EthanN1e/X1aoChuang-NYH/original-project/README.md

# 原开源资料归档

[完整原始资料归档](full-original.zip) 含原始工程以及 Objects 和 Listings 构建产物。为方便浏览，目录中单独列出源码、模型及其余资料。

本目录保存提供的原始云台资料：发射端与接收端 Keil 工程、STL 和 3MF、PCB Gerber、原物料清单，以及原资料中已有的构建文件。它们是上游项目资料，供复现与核对使用，不能视为本项目已经完成的改造。

项目立项范围以手控、中性载荷台架为准；原资料包含的其他机构与控制内容仅作为上游资料保留。原演示视频：https://www.bilibili.com/video/BV1of8y6vEQ5/ 。

未在所提供资料中发现完整的项目许可证。部分第三方代码声明其权利归原作者所有，且提到的 License.txt 未随资料提供。版权及授权归原作者；使用、修改或再次分发前，请核实上游和第三方组件的许可。不得将本仓库视为对这些文件的重新授权。
