EthanN1e/X1aoChuang-NYH/reference-display/README.md

# 显示项目参考资料

这里包含提供的 monitor 工程和电路图，供理解 ST7735 彩屏、编码器和按键连接方式。该工程原本运行在 ESP32-C3，手控云台使用 STM32 的显示移植仍待开发和测试。

公开版本中的 Wi-Fi 名称和密码已清空；如确需运行联网功能，请在本地配置，勿将凭据提交到仓库。屏幕供电、电平、接口和实物型号仍需核对。
