EthanN1e/X1aoChuang-NYH/hardware/r0/README.md

# R0 集成 PCB

| 文件 | 用途 |
| --- | --- |
| [gimbal-r0.epro2](gimbal-r0.epro2) | 嘉立创 EDA 专业版工程，包含三页原理图和 PCB1 |
| [assembly-bom.xlsx](assembly-bom.xlsx) | 两端焊接位号、型号、立创料号、数量及外接配件 |
| [pcb1-drc.json](pcb1-drc.json) | 保存并重载后得到的原生 DRC 记录，0 项违规 |

同版四层裸板 56 × 80 mm，一套用两块。手柄端装 63 件，包含 MPU-6050、1S 充电和 3.3 V 稳压。云台端装 36 件，接两只位置型舵机，由 J12 输入共地的稳压 3.3 V 和舵机电源。两端各接一个 nRF24L01+ 模块。R7、R26、J13 默认留空。

J6 预留带按压的 A/B 增量编码器，J5 接 ST7735 屏。屏幕与无线模块针序、外壳尺寸、舵机电流和供电余量待实物核对。R0 固件适配和两端联调仍待完成。

## 2026-11-05 板级复查与装配评审

本次在线 PCB DRC 未报告违规，但固定方向的 15 个手柄安装候选均与原壳网格相交，外壳适配尚未通过。请先看[复查结果与离线三维展示](review-20261105/README.md)。当前工程是审核修订版，尚未制造放行。

## 2026-11-06 电阻布局和走线优化

[新版嘉立创 EDA 专业版工程](resistor-layout-20261106/R0-resistor-layout.epro2)供本轮 PCB 审阅。[前后对照图](resistor-layout-20261106/resistor-layout-before-after.png)标出 J4 局部走线和全板改位的电阻。

检查全板 27 颗 0603 电阻，改位并重布线 11 颗。R5、R6 水平布置，RF_CE 和 RF_CSN 在 J4 下方改为平行直段配短 45° 转角。右侧 R7–R12 对齐。保存重开后严格 DRC 为 0 项违规，74 个器件引脚网络一致，54 个电阻焊盘的顶层阻焊开窗已核对。详见[核验记录](resistor-layout-20261106/verification.json)。样板焊接和制造审核待验证。
