EthanN1e/X1aoChuang-NYH/planning/DeepSeek任务/01_打印结构审查.md

# 任务 01 现有 STL 的结构审查与虚拟装配

请只使用用户提供的底座、Yaw 底座、Pitch 轴相关 STL，为无发射机构的双轴手控云台建立虚拟装配。原文件中其他结构件可能形成装配依赖，但不得把发射相关零件放入交付模型。若某个关键连接因缺件无法闭合，应明确报告缺件与所需的中性替代件。

工作：逐件列出文件名、包围盒尺寸、坐标方向、网格完整性、建议打印方向；在 CAD 中检查孔位与轴线相对位置、运动干涉、紧固件空间；给出需实测尺寸和需新画的中性载荷安装件清单。不得凭 STL 文件名推断物理尺寸精度。

交付：可编辑装配文件、零件清单 CSV、关键尺寸截图、干涉报告、打印试装建议。验收：他人可按文件名重新导入并复现检查；所有未知尺寸标记待测。
