EthanN1e/X1aoChuang-NYH/planning/DeepSeek任务/02_舵机载荷与活动空间.md

# 任务 02 MG996R 舵机载荷与活动空间模型

请针对不带发射机构的中性载荷台架，建立简单的静态载荷、重心和活动空间模型。输入为实测打印件质量、两只 MG996R 的所购批次参数、轴距和中性载荷质量。没有实测数据时全部参数化，不得代入未经来源确认的产品值。

工作：计算不同中性载荷质量及安装位置下的静态受力与重心偏移；基于 STL 虚拟装配检查双轴活动范围、线束余量和可能碰撞处；提供参数敏感性图。结论只用于试装优先级与测量计划，不保证实物承载性能。

交付：源脚本或电子表格、输入参数 CSV、图表、假设和实测计划。验收：改变载荷质量和轴距后自动重算；标出不确定性；不使用发射相关部件。
