EthanN1e/X1aoChuang-NYH/planning/DeepSeek任务/03_供电预算.md

# 任务 03 原项目供电预算

请根据用户提供的 Excel 原 BOM 和实际盘点结果，为两块 STM32、两只 nRF24L01、MPU6050、两只 MG996R、显示和按键建立供电预算。只覆盖无发射机构的手控云台。7.4 V、3.7 V 电池及 5 V 降压模块是原 BOM 物料，实际是否可用须待测，不得默认兼容。

工作：建立模块功率与峰值电流参数表；区分手册数据、实测和未知；比较电源、降压、导线与连接器的余量；列出需要万用表或示波器确认的指标。不得给出未验证的电池安全结论。

交付：电源树、可编辑预算表、不同工作场景汇总、待测清单。验收：所有输入有来源或“待测”标识；原 Excel 未填数量的线材不按已有处理。
