EthanN1e/X1aoChuang-NYH/hardware/r0/resistor-layout-20261106/resistor-layout-before-after.png

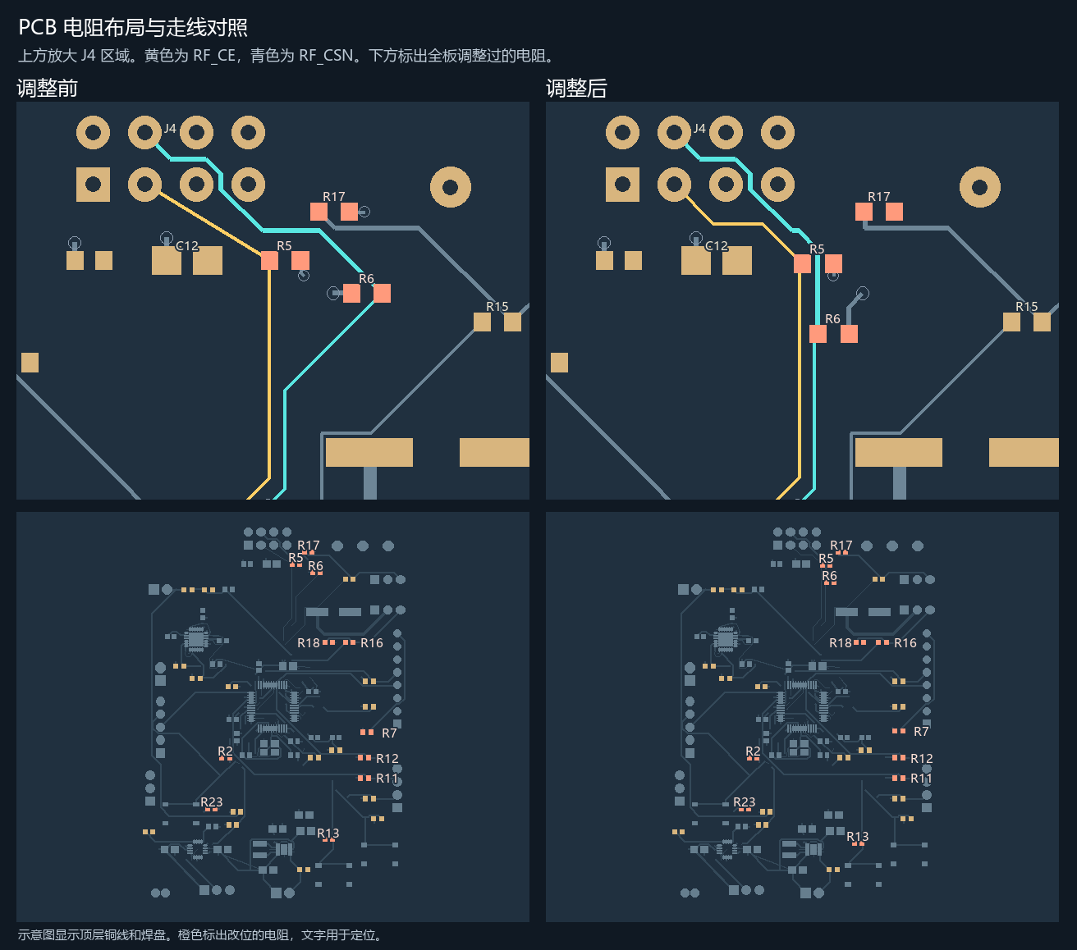
hardware/r0/resistor-layout-20261106/resistor-layout-before-after.png
