EthanN1e/X1aoChuang-NYH/planning/手柄彩屏界面草案.png

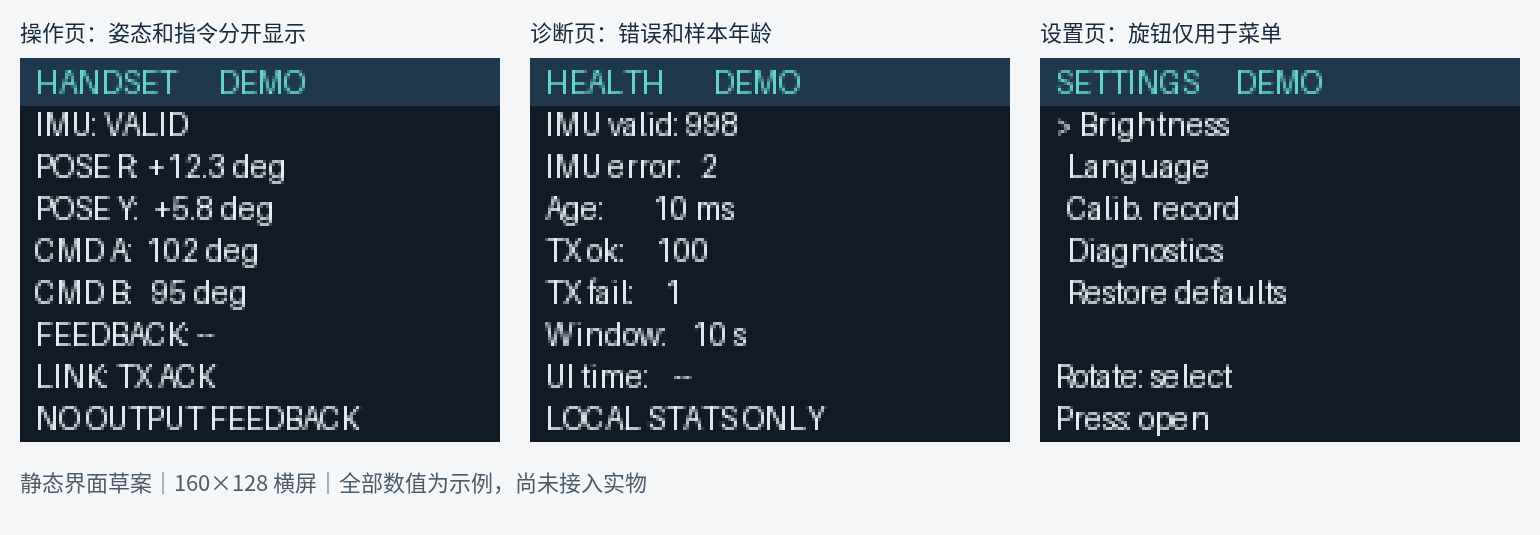
planning/手柄彩屏界面草案.png
