EthanN1e/X1aoChuang-NYH/reference-display/电路图.jpg

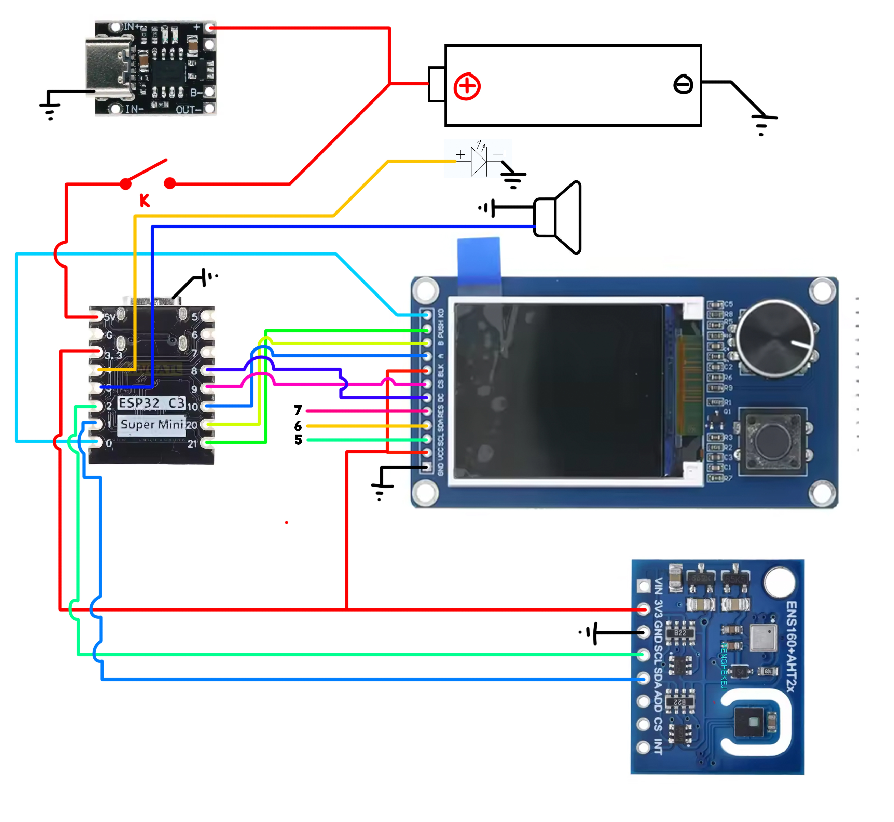
reference-display/电路图.jpg
