EthanN1e/X1aoChuang-NYH/planning/准备清单.csv

物料 | 所需数量说明 | 依据 | 库存状态 | 可用库存数量 | 规格核对及检索词 | 商品链接及SKU | 单价元 | 实际采购量 | 核对状态
STM32F103C8T6 | 2 | 原BOM | 待盘点 |  | 原 BOM；核对板型、晶振、稳压、下载接口及实际芯片标记。 |  |  |  | 待核对
nRF24L01 模块 | 2 | 原BOM | 待盘点 |  | 原 BOM；核对普通/带功放版本、供电、引脚及板间距离。 |  |  |  | 待核对
MPU6050 模块 | 1 | 原BOM | 待盘点 |  | 原 BOM；核对板型、电平、供电和手柄固定方向。 |  |  |  | 待核对
MG996R 舵机 | 2 | 原BOM | 待盘点 |  | 原 BOM；核对来源、工作电压、舵盘、连接与实际电流。 |  |  |  | 待核对
7.4 V 与 3.7 V 电池 | 各 1 | 原BOM | 待盘点 |  | 原 BOM；先核对化学体系、串数、保护和接口，再决定复用。 |  |  |  | 待核对
迷你 5 V DC-DC | 1 | 原BOM | 待盘点 |  | 原 BOM；核实输入范围与持续/瞬态供电能力，不能只看标称电流。 |  |  |  | 待核对
12×12 按键与 SS12D07G3 开关 | 各 2 | 原BOM | 待盘点 |  | 原 BOM；确认安装尺寸、接点和额定值。 |  |  |  | 待核对
排针及连接线 | 1 批 | 原BOM | 待盘点 |  | 原 BOM 无明确数量；按最终针脚表计数，区分信号线与电源线。 |  |  |  | 待核对
底座及双轴打印件 | 1 套 | 方案建议 | 待盘点 |  | 按 STL 装配关系清点；材料和填充率结合载荷试装确定。 |  |  |  | 待核对
紧固件与舵盘连接件 | 1 套 | 方案建议 | 待盘点 |  | 尺寸从模型与实物取值，记录螺钉长度及防松方式。 |  |  |  | 待核对
中性载荷安装件 | 1 套 | 方案建议 | 待盘点 |  | 适配双轴结构；记录质量、重心与独立测量基准。 |  |  |  | 待核对
电源保护及分配件 | 1 套 | 方案建议 | 待盘点 |  | 按实际电流确定保险、开关、接线端子与应力释放。 |  |  |  | 待核对
适配充电器 | 按电池体系 | 方案建议 | 待盘点 |  | 与电池串数、化学体系、保护方式匹配；原清单未明确。 |  |  |  | 待核对
下载与测量工具 | 复用或借用 | 方案建议 | 待盘点 |  | ST-Link、3.3 V 逻辑串口工具、万用表；按测试需要借用逻辑分析仪和可调电源。 |  |  |  | 待核对
ST7735 旋钮彩屏 | 1 | 方案建议 | 待盘点 |  | 优先复用同款；核对 128×160、SPI、编码器 A/B、按键、电平与孔距。检索：ST7735 彩屏 旋转编码器 模块。 |  |  |  | 待核对
屏幕支架和手柄上盖 | 1 套 | 方案建议 | 待盘点 |  | 按屏幕实测外形与孔位修改；检索：3D 打印 手柄 外壳 定制。 |  |  |  | 待核对
可靠插接件与柔性导线 | 1 套 | 方案建议 | 待盘点 |  | 按电流、间距、线径与接口选型；检索：带锁扣 连接器 线束。 |  |  |  | 待核对
独立返回键 | 0～1 | 方案建议 | 待盘点 |  | 同款模块若已提供则复用；检索：轻触 按键 模块。 |  |  |  | 待核对
角度夹具或独立测角工具 | 1 套 | 方案建议 | 待盘点 |  | 分辨率不是准确度，需核实校准与量程；检索：数显角度尺 固定夹具。 |  |  |  | 待核对
电池电压采样元件 | 条件项 | 方案建议 | 待盘点 |  | 确认电池最大电压和 ADC 允许范围后设计；显示百分比还需电池模型。 |  |  |  | 待核对
背光驱动或电平转换 | 条件项 | 方案建议 | 待盘点 |  | 只有核实模块电路后才能确定是否需要，不能统一默认添加。 |  |  |  | 待核对
