EthanN1e/X1aoChuang-NYH/hardware/r0/assembly-bom.xlsx

Sheet: 板载器件
R0 板载器件清单
一套 = 手柄端 PCB 1 块 + 云台端 PCB 1 块。以下为实际装配用量，0 表示默认留空。
数据来自 R0-DRC修复.epro2 的器件库和 PCB1 读回，覆盖全部 74 个 PCB 位号。请按两端焊接位号分料。
类别 | 已绑定器件型号 | 立创料号 | 封装／规格 | PCB 位号 | 手柄端 | 云台端 | 两板合计 | 手柄焊接位号 | 云台焊接位号 | 装配说明
主控 | STM32F103C8T6 | C8734 | LQFP-48，7 × 7 mm | U1 | 1 | 1 | 2 | U1 | U1 | 两端各一颗，分别烧录发射端和接收端固件。
姿态传感器 | MPU-6050 | C24112 | QFN-24，4 × 4 mm | U2 | 1 | 0 | 1 | U2 | — | 裸芯片上板，建议 SMT。25 号裸露焊盘按手册复核钢网开口。
充电与电源路径 | BQ24074RGTR | C54313 | VQFN-16，3 × 3 mm | U3 | 1 | 0 | 1 | U3 | — | 手柄端单节锂电池。建议 SMT。
3.3 V 升降压 | TPS63031DSKR | C15516 | VSON-10，2.5 × 2.5 mm | U4 | 1 | 0 | 1 | U4 | — | 手柄端逻辑供电。建议 SMT。
晶振 | X32258MOB4SI | C2682775 | 3225 四焊盘，8 MHz，CL 12 pF | Y1 | 1 | 1 | 2 | Y1 | Y1 | 与 C1、C2 配套。
功率电感 | VLS3015CX-1R5M-1 | C3223987 | 贴片，约 3 × 3 mm，1.5 µH | L1 | 1 | 0 | 1 | L1 | — | 手柄端 U4 升降压用。
电阻 | RC0603FR-0710KL | C98220 | 0603，10 kΩ，±1% | R1、R2、R3、R5、R6、R8、R9、R10、R11、R12、R13、R14、R17、R18、R25 | 13 | 7 | 20 | R1、R2、R3、R5、R6、R8、R9、R10、R11、R12、R13、R14、R25 | R1、R2、R3、R5、R6、R17、R18 | 两端位号不同，按各自列焊。
电阻 | RC0603JR-070RL | C95177 | 0603，0 Ω | R4 | 1 | 1 | 2 | R4 | R4 | 两端均装，模拟电源连接。
预留跳线 | RC0603JR-070RL | C95177 | 0603，0 Ω | R7、R26 | 0 | 0 | 0 | — | — | 默认留空。R7 待核对屏幕背光，R26 待验证关机漏电。
电阻 | RC0603FR-07100RL | C105588 | 0603，100 Ω，±1% | R15、R16 | 0 | 2 | 2 | — | R15、R16 | 云台端两路舵机 PWM 串联。
电阻 | RC0603FR-07100KL | C14675 | 0603，100 kΩ，±1% | R19、R27 | 2 | 1 | 3 | R19、R27 | R19 | R19 两端均装，R27 手柄端装。
电阻 | RC0603FR-0733KL | C126359 | 0603，33 kΩ，±1% | R20 | 1 | 1 | 2 | R20 | R20 | 电压采样分压。
电阻 | RC0603FR-074K7L | C99782 | 0603，4.7 kΩ，±1% | R21、R22 | 2 | 0 | 2 | R21、R22 | — | 手柄端 IMU 的 I²C 上拉。
电阻 | RC0603FR-073K24L | C273779 | 0603，3.24 kΩ，±1% | R23 | 1 | 0 | 1 | R23 | — | 充电电路设置电阻。
电阻 | RC0603FR-074K53L | C273802 | 0603，4.53 kΩ，±1% | R24 | 1 | 0 | 1 | R24 | — | 充电电流设置，按实际电芯允许充电电流核对。
陶瓷电容 | CL10C180JB8NNNC | C1647 | 0603，18 pF，50 V，C0G | C1、C2 | 2 | 2 | 4 | C1、C2 | C1、C2 | 晶振负载。
陶瓷电容 | CL10B104KB8NNNC | C1591 | 0603，100 nF，50 V，X7R | C3、C4、C5、C6、C8、C10、C11、C13、C14、C15 | 10 | 8 | 18 | C3、C4、C5、C6、C8、C10、C11、C13、C14、C15 | C3、C4、C5、C6、C8、C10、C11、C13 | C14、C15 仅手柄端装。
陶瓷电容 | CL21B104KBCNNNC | C1711 | 0805，100 nF，50 V，X7R | C22 | 1 | 0 | 1 | C22 | — | 手柄端稳压电路。与 0603 的 100 nF 分开领料。
陶瓷电容 | CL10A105KB8NNNC | C15849 | 0603，1 µF，50 V，X5R | C9、C18 | 2 | 1 | 3 | C9、C18 | C9 | C9 两端装。最终 PCB 的 C18 是 0603，仅手柄端装。
陶瓷电容 | CL21A106KAYNNNE | C2980800 | 0805，10 µF，25 V，X5R | C7、C12、C19、C20、C21、C23、C24 | 7 | 2 | 9 | C7、C12、C19、C20、C21、C23、C24 | C7、C12 | C7、C12 两端装。最终 PCB 的 C7 是 0805。
陶瓷电容 | CL10B222KB8NNNC | C16033 | 0603，2.2 nF，50 V，X7R | C16 | 1 | 0 | 1 | C16 | — | 手柄端 IMU 外围。
陶瓷电容 | CL10B103KB8NNNC | C1589 | 0603，10 nF，50 V，X7R | C17 | 1 | 0 | 1 | C17 | — | 手柄端 IMU 外围。
电解电容 | EEEFK1C471P | C79121 | SMD，470 µF，16 V，直径 8 mm | C25 | 0 | 1 | 1 | — | C25 | 云台端舵机供电缓冲，焊接时核对极性。
轻触开关 | TS-1187A-B-A-B | C318884 | 贴片，5.1 × 5.1 × 1.5 mm | SW1、SW2、SW3 | 3 | 1 | 4 | SW1、SW2、SW3 | SW1 | SW1 复位，两端装。SW2 归零、SW3 微调，仅手柄装。
SWD 排针 | PZ254V-11-05P | C492404 | 1×5，2.54 mm，直插公针 | J1 | 1 | 1 | 2 | J1 | J1 | VREF / SWDIO / SWCLK / NRST / GND。
串口／舵机排针 | PZ254V-11-03P | C2937625 | 1×3，2.54 mm，直插公针 | J2、J7、J8 | 1 | 3 | 4 | J2 | J2、J7、J8 | J2 两端装。J7 水平、J8 俯仰，仅云台端装。
BOOT0／开关排针 | PZ254V-11-02P | C492401 | 1×2，2.54 mm，直插公针 | J3、J11 | 2 | 1 | 3 | J3、J11 | J3 | J3 两端装，正常启动时跳线帽取下。J11 仅手柄端装。
采样预留排针 | PZ254V-11-02P | C492401 | 1×2，2.54 mm，直插公针 | J13 | 0 | 0 | 0 | — | — | 默认留空。云台端启用电压采样时增加 1 个，1 脚 GND、2 脚采样。
无线排母 | PM2.54-2x4PZZ-H8.5 | C54876740 | 2×4，2.54 mm，直插母座 | J4 | 1 | 1 | 2 | J4 | J4 | 两端各一座。nRF24L01+ 射频模块另列。
显示屏排针 | PZ254V-11-08P | C492407 | 1×8，2.54 mm，直插公针 | J5 | 1 | 0 | 1 | J5 | — | 手柄端。用线束按信号配线，核对 VCC 与 BL。
编码器排针 | PZ254V-11-04P | C2691448 | 1×4，2.54 mm，直插公针 | J6 | 1 | 0 | 1 | J6 | — | 手柄端。顺序为 GND、A、B、SW。
5 V 输入座 | B2B-PH-K-S | C20504437 | JST PH 1×2，2.00 mm，直插 | J9 | 1 | 0 | 1 | J9 | — | 手柄端。1 脚 5 V，2 脚 GND。
1S 电池座 | B3B-XH-AM(LF)(SN) | C161870 | JST XH 1×3，2.50 mm，直插 | J10 | 1 | 0 | 1 | J10 | — | 手柄端。1 脚 BAT+，2 脚 NTC，3 脚 GND。
云台稳压输入 | DG301-5.0-03P-12-00A(H) | C5128849 | 1×3，5.00 mm，螺钉端子 | J12 | 0 | 1 | 1 | — | J12 | 1 脚 GND，2 脚稳压 3.3 V，3 脚稳压舵机电源。
板载件合计 |  |  |  |  | 63 | 36 | 99

Sheet: 外接配件
外接模块、线束与调试件
按一套整机统计。共用／选配另计，屏幕、电池与外接稳压型号以备注中的实物条件为准。
依据 R0 的 J1–J13、原始物料清单及 monitor.ino。外接配件用量与板载插座分开统计。
分组 | 配件 | 型号／选型 | 规格 | 手柄端 | 云台端 | 共用／选配 | 接法与下单前核对
整机 | 同版裸 PCB | 手控云台 R0 DRC 修复版 | 56 × 80 mm，4 层 | 1 | 1 | 0 | 同一板图制作两块，按本表分别装配。
无线 | SPI 射频模块 | nRF24L01+ PCB 天线版 | 2×4，2.54 mm 公针，3.3 V | 1 | 1 | 0 | J4。板端顺序 GND / 3.3 V / CE / CSN / SCK / MOSI / MISO / NC。按模块实物核对方向。
显示 | SPI TFT 屏 | ST7735，128 × 160，8 针候选 | 3.3 V 逻辑，沿用 monitor 项目屏 | 1 | 0 | 0 | J5。PCB 顺序 GND / 3.3 V / SCK / MOSI / RST / DC / CS / BL。实物商品号和背光接法待核对。
操作 | 旋转编码器 | ALPS Alpine EC11E15244G1 | 增量 A/B，带按压，20 mm 扁轴候选 | 1 | 0 | 0 | J6。编码器公共端与按键地并接，合成 GND、A、B、SW 四线。轴长按外壳确认。
操作 | 编码器旋钮帽 | EC11 扁轴配套旋钮帽 | 按编码器轴截面和外壳选 | 1 | 0 | 0 | 与上行编码器匹配，外壳尺寸确认后定具体型号。
操作 | 面板电源开关 | 原清单 SS12D07G3 候选 | 保持型，两档，仅用公共端和一档 | 1 | 0 | 0 | J11 控制 REG_EN。用通断档确认触点脚位，J11 不承载舵机电流。
执行 | 位置型舵机 | TowerPro MG996R | 两轴各 1，只选位置型 | 0 | 2 | 0 | J7 / J8，GND / VSERVO / PWM。两只舵机的启动与负载峰值电流决定供电规格。
手柄供电 | 1S 电池 | 受保护单节 3.7 V 锂电池组 | 满充 4.2 V，配匹配的 10 kΩ NTC | 1 | 0 | 0 | J10。电芯型号与容量按仓位和允许充电电流定，线序按 BAT+ / NTC / GND。
手柄供电 | 充电适配器 | 5 V 稳压适配器 | 5 V / 1 A 或以上，配 J9 线束 | 1 | 0 | 0 | 手柄板载 BQ24074 负责 1S 充电。电源端接 PH 2P 线束，核对极性。
云台供电 | 2S 电池 | 7.4 V 受保护电池组 | 满充 8.4 V，容量与接头待定 | 0 | 1 | 0 | 按原物料表电压。选与充电器和负载匹配的电池组，经稳压再接 J12。
云台供电 | 2S 充电器 | 2S 8.4 V 匹配充电器 | 型号按电池保护、均衡及接头确定 | 0 | 1 | 0 | 匹配电池组厂家要求的充电方式和充电电流。
云台供电 | 逻辑稳压 | Pololu D24V22F3（候选） | 3.3 V 降压 | 0 | 1 | 0 | 接 J12.2。可采用符合输入范围和输出要求的同类板外电源。
云台供电 | 舵机稳压 | 5 V 大电流 BEC／降压模块 | Pololu D24V90F5 为候选 | 0 | 1 | 0 | 接 J12.3。依据双舵机峰值电流和低电量输入余量确认。与 3.3 V 共地。
线束 | 屏幕线束 | 2.54 mm 8 芯 | PCB 端为母头，屏端按实物 | 1 | 0 | 0 | J5。根据针序逐线压接或转接。
线束 | 编码器线束 | 2.54 mm 4 芯母头至焊线 | GND / A / B / SW | 1 | 0 | 0 | J6。编码器按外壳布线长度预留。
线束 | 电源开关线束 | 2.54 mm 2 芯母头至焊线 | SYS_1S / REG_EN | 1 | 0 | 0 | J11。
线束 | 5 V 输入线束 | JST PHR-2 配 PH 端子 | 2.00 mm，2 芯带线插头 | 1 | 0 | 0 | 配 J9。适配器带相同插头且极性一致时与适配器合并采购。
线束 | 1S 电池线束 | JST XHP-3 配 XH 端子 | 2.50 mm，3 芯带线插头 | 1 | 0 | 0 | 配 J10。电池已带兼容插头且针序正确时与电池合并采购。
线束 | 云台动力与逻辑线 | 电池到稳压模块、稳压模块到 J12 | 按实测电流、线长及 J12 夹线范围选线径 | 0 | 1 | 0 | 一套。舵机动力走额定电流合适的线束。
线束 | 舵机延长线 | 2.54 mm 3 芯舵机延长线 | 长度按轴行程确定 | 0 | 0 | 2 | 最多 2 条备用，舵机原线够长时数量为 0。
机械 | 舵盘与固定件 | MG996R 配套舵盘、螺钉与支架紧固件 | 按两轴和 3D 打印件孔位配 | 0 | 2 | 0 | 按 2 轴计，每轴 1 套。舵机随附且匹配时合并采购。
调试 | 下载器与线 | ST-LINK/V2 + 5 芯 SWD 转接线 | 3.3 V 目标电平，J1 | 0 | 0 | 1 | 整套共用 1 套。已有可复用。目标板需自行供电，J1 的 VREF 用作参考。
调试 | 短路帽 | 2.54 mm 两针跳线帽 | J3 BOOT0 | 0 | 0 | 1 | 两板共用 1 个。日常运行时取下。
调试 | 串口调试器与线 | 3.3 V TTL USB 转串口 | J2，GND / TX / RX | 0 | 0 | 1 | 整套共用，可选。TX/RX 交叉，调试口用于信号。
EC11 官方规格 |  | https://tech.alpsalpine.com/c/products/detail/EC11E15244G1/
MG996R 官方规格 |  | https://towerpro.com.tw/product/mg996R/
3.3 V 降压候选 |  | https://www.pololu.com/product/2857
5 V 降压候选 |  | https://www.pololu.com/product/2866
