EthanN1e/X1aoChuang-NYH/original-project/开源模型/物料清单.xlsx

自购物料清单
名称 | 数量 | 备注
STM32F103C8T6单片机 | 2
NRF24L01无线模块 | 2
MPU6050模块 | 1
MG996R舵机 | 2
7.4v锂电池 | 1
3.7v锂电池 | 1
mini DC-DC 5v降压模块 | 1
水弹发射器 | 1
12*12立式按动开关 | 2
SS12D07G3_5脚2档开关 | 2
5v1路继电器模块 | 1
排针排母
杜邦线
