EthanN1e/X1aoChuang-NYH/mechanical/minimal-r4/R4-PCB-Support-TRIAL.STL

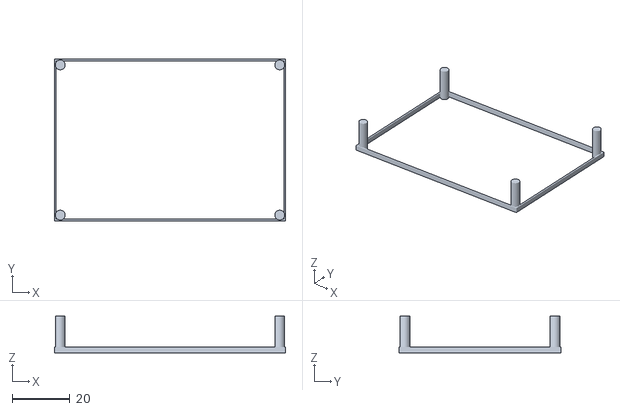
[picture p7: CAD file, 2026-11-05]
mechanical/minimal-r4/R4-PCB-Support-TRIAL.STL
80.0 x 56.0 x 12.7
