EthanN1e/X1aoChuang-NYH/original-project/开源模型/底座1.STL

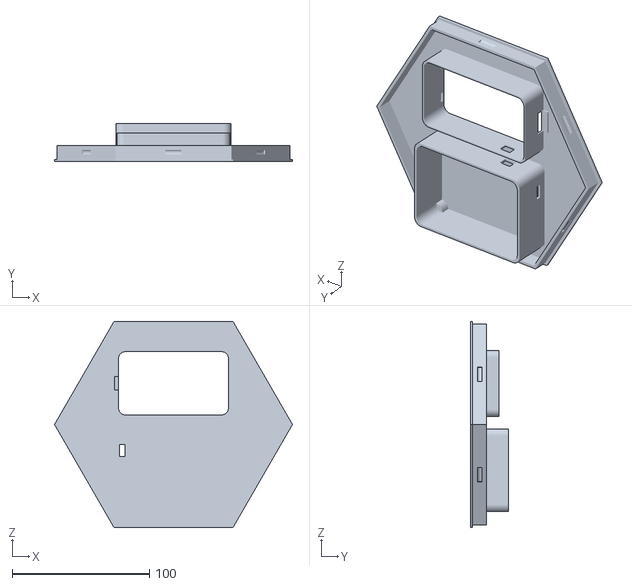
[picture p8: CAD file, 2026-10-30]
original-project/开源模型/底座1.STL
173.2 x 27.6 x 150.0
