EthanN1e/X1aoChuang-NYH/original-project/开源模型/底座3.STL

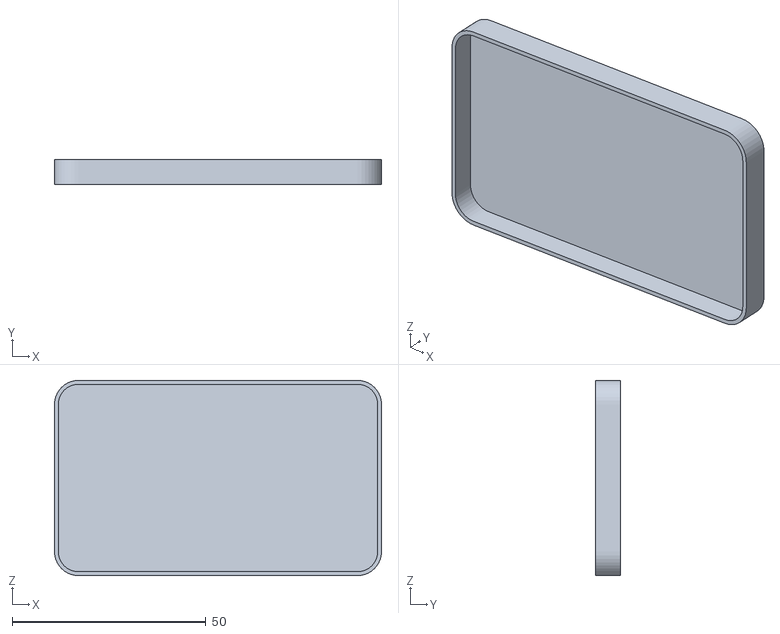
[picture p9: CAD file, 2026-10-30]
original-project/开源模型/底座3.STL
84.3 x 6.50 x 50.3
