EthanN1e/X1aoChuang-NYH/original-project/开源模型/底座4.STL

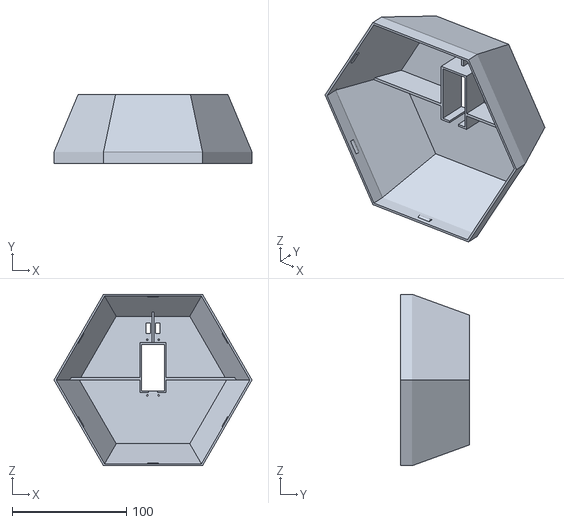
[picture p10: CAD file, 2026-10-30]
original-project/开源模型/底座4.STL
173.2 x 60.0 x 150.0
