EthanN1e/X1aoChuang-NYH/original-project/开源模型/Yaw底座1.STL

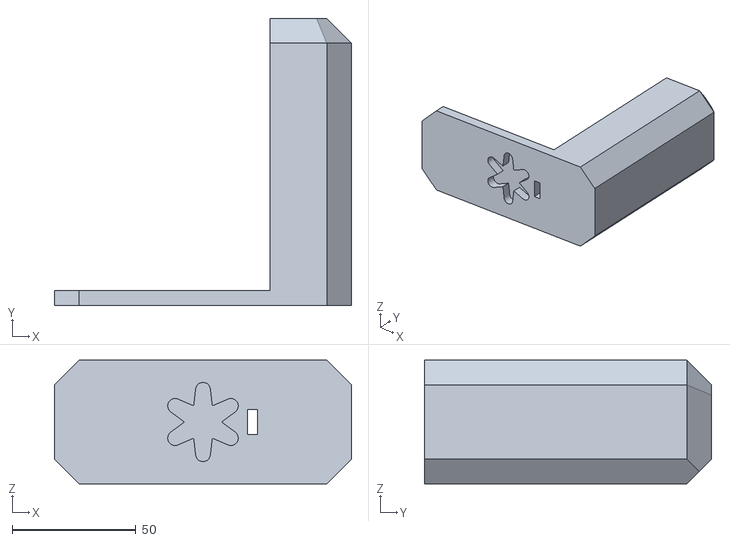
[picture p11: CAD file, 2026-10-30]
original-project/开源模型/Yaw底座1.STL
120.0 x 116.0 x 50.0
