EthanN1e/X1aoChuang-NYH/original-project/开源模型/枪体壳3.STL

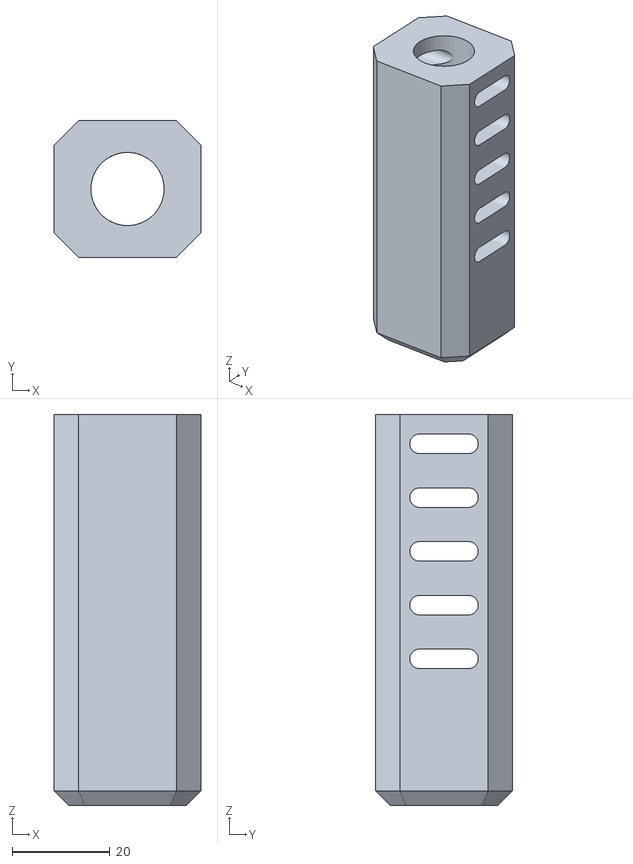
[picture p12: CAD file, 2026-10-30]
original-project/开源模型/枪体壳3.STL
30.0 x 28.0 x 80.0
