EthanN1e/X1aoChuang-NYH/original-project/开源模型/枪体壳2.STL

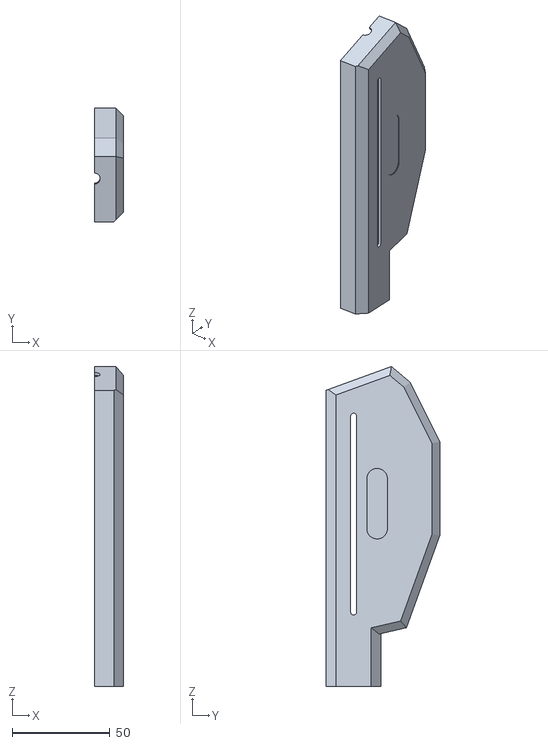
[picture p13: CAD file, 2026-10-30]
original-project/开源模型/枪体壳2.STL
15.0 x 58.0 x 163.3
