EthanN1e/X1aoChuang-NYH/original-project/开源模型/Pitch轴2.STL

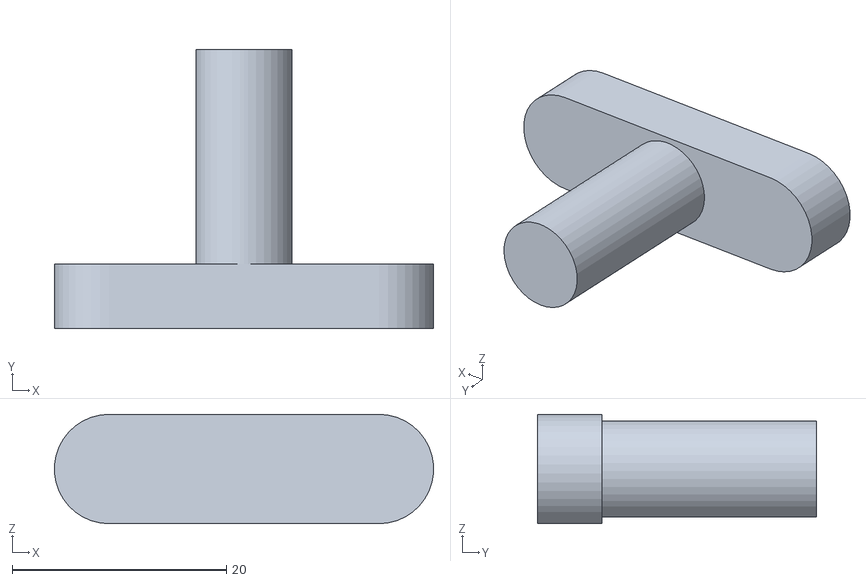
[picture p14: CAD file, 2026-10-30]
original-project/开源模型/Pitch轴2.STL
35.4 x 26.0 x 10.2
