EthanN1e/X1aoChuang-NYH/original-project/开源模型/体感云台发射器打印模型.3mf

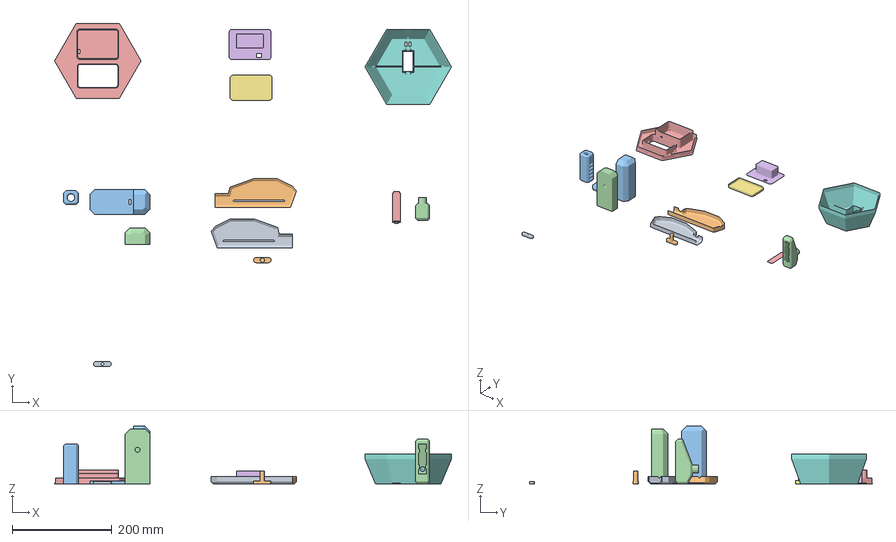
[picture p15: CAD file, 2026-10-30]
original-project/开源模型/体感云台发射器打印模型.3mf
794.5 x 686.9 x 116.0 mm
Pitch轴1.STL
Pitch轴2.STL
Yaw底座1.STL
Yaw底座2.STL
底座1.STL
底座2.STL
底座3.STL
底座4.STL
枪体壳1.STL
枪体壳2.STL
枪体壳3.STL
水单仓1.STL
水单仓2.STL
