EthanN1e/X1aoChuang-NYH/original-project/开源模型/Yaw底座2.STL

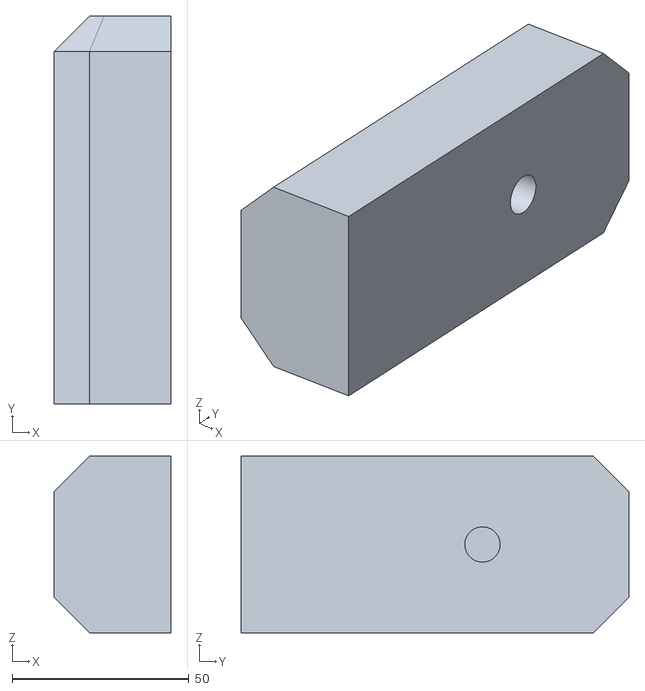
[picture p16: CAD file, 2026-10-30]
original-project/开源模型/Yaw底座2.STL
33.0 x 109.9 x 50.0
