EthanN1e/X1aoChuang-NYH/original-project/开源模型/Pitch轴1.STL

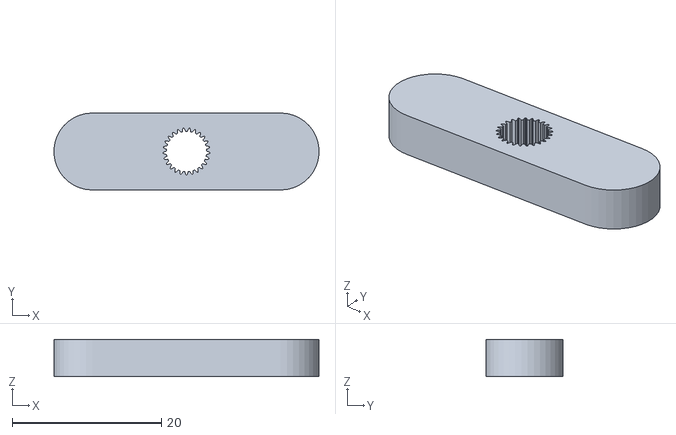
[picture p17: CAD file, 2026-10-30]
original-project/开源模型/Pitch轴1.STL
35.5 x 10.3 x 5.00
