EthanN1e/X1aoChuang-NYH/original-project/开源模型/水单仓1.STL

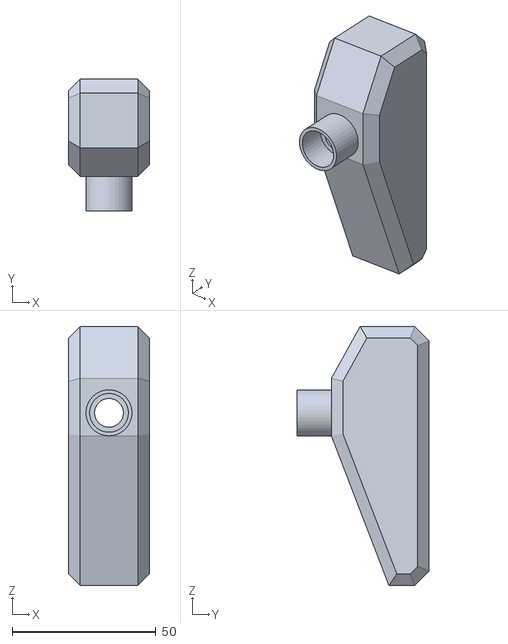
[picture p18: CAD file, 2026-10-30]
original-project/开源模型/水单仓1.STL
28.0 x 46.0 x 90.0
