EthanN1e/X1aoChuang-NYH/original-project/开源模型/水单仓2.STL

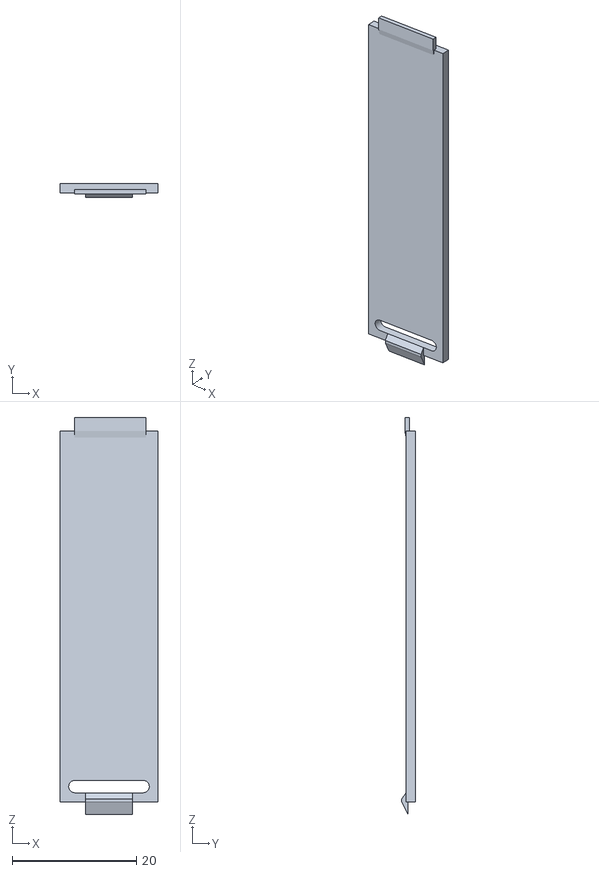
[picture p19: CAD file, 2026-10-30]
original-project/开源模型/水单仓2.STL
15.8 x 2.20 x 64.0
