EthanN1e/X1aoChuang-NYH/original-project/开源模型/底座2.STL

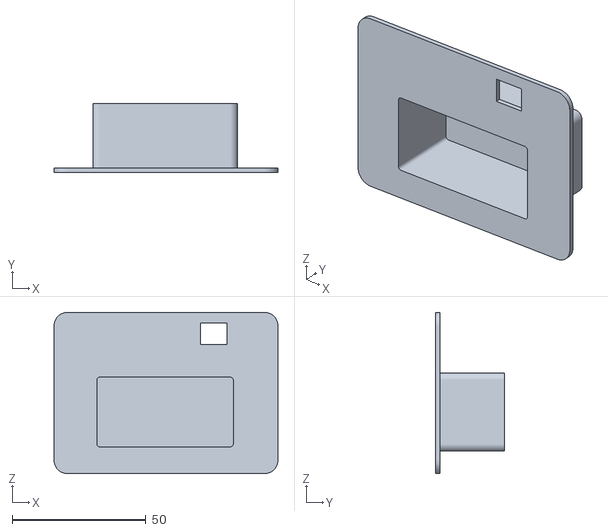
[picture p20: CAD file, 2026-10-30]
original-project/开源模型/底座2.STL
83.7 x 25.6 x 60.2
