EthanN1e/X1aoChuang-NYH/(list of files, cad)

Other CAD files:
mechanical/minimal-r4/R4-Base1.step
original-project/开源模型/枪体壳1.STL
