EthanN1e/X1aoChuang-NYH/planning/DeepSeek任务/04_无线日志仿真.md

# 任务 04 体感无线链路日志仿真

请依据发射端和接收端源码，静态整理 MPU6050 姿态读取、nRF24L01 数据发送/接收和舵机输入之间的数据关系；使用合成数据建立只读日志分析器，不连接任何实体设备、不输出执行命令。

工作：输出消息字段与代码出处；制造正常、丢包、重复、乱序、过期和断链数据；统计接收率、数据新鲜度和异常出现位置；记录源码中哪些异常路径缺少明确处理。不要修改发射相关 GPIO 路径，也不要实现新的控制功能。

交付：源码调用图、样本 CSV/JSON、分析脚本、统计报告、README。验收：合成数据可固定随机种子复现；脚本不打开串口或无线设备；每个结论能对应代码行或测试样本。
