EthanN1e/X1aoChuang-NYH/mechanical/minimal-r4/Drawings/PCB-Support-R4-DRAFT.pdf

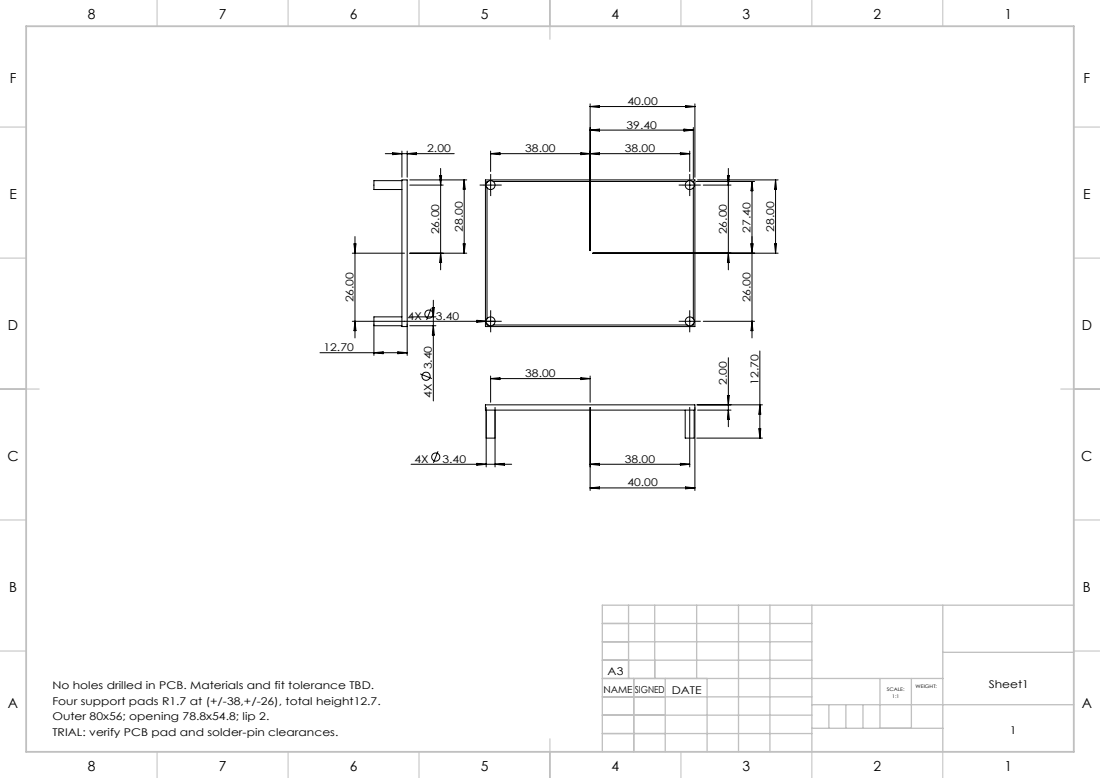
[picture p21: page 1]

No holes drilled in PCB. Materials and fit tolerance TBD.

NAME SIGNED | DATE | 1:1 | WEIGHT: SCALE:

Four support pads R1.7 at (+/-38,+/-26), total height12.7.
Outer 80x56; opening 78.8x54.8; lip 2.
TRIAL: verify PCB pad and solder-pin clearances.
