EthanN1e/X1aoChuang-NYH/(commit log)

2026-10-30 介绍手控双轴云台项目并添加立项资料
2026-10-30 修正项目协作入口链接
2026-10-30 上传云台项目原始资料与立项协作文件
2026-11-03 同步 R0 集成 PCB、DRC 记录与两端装配清单
2026-11-05 归档 R0 在线复查、实际 PCB 三维模型与原壳碰撞展示
2026-11-05 保留原底座双仓并整合 PCB 与 76x36x18 电池的 R4 试装方案
2026-11-05 修复新增框件的装配引用并重开确认全部8组件解析后复核干涉
2026-11-05 将电池框出线缺口加深至6mm并更新图纸、通道净空记录及原生审阅包
2026-11-05 补齐R4主分支同步、原生包还原步骤及完整性验证说明
2026-11-05 保留Windows检出时CAD、PDF和分卷原始字节并补充说明
2026-11-06 同步 R0 电阻布局优化及 PCB 核验记录
